marex-design/design_3v3_1v8_ltspice/design/pdf_schematic_ltspice.pdf

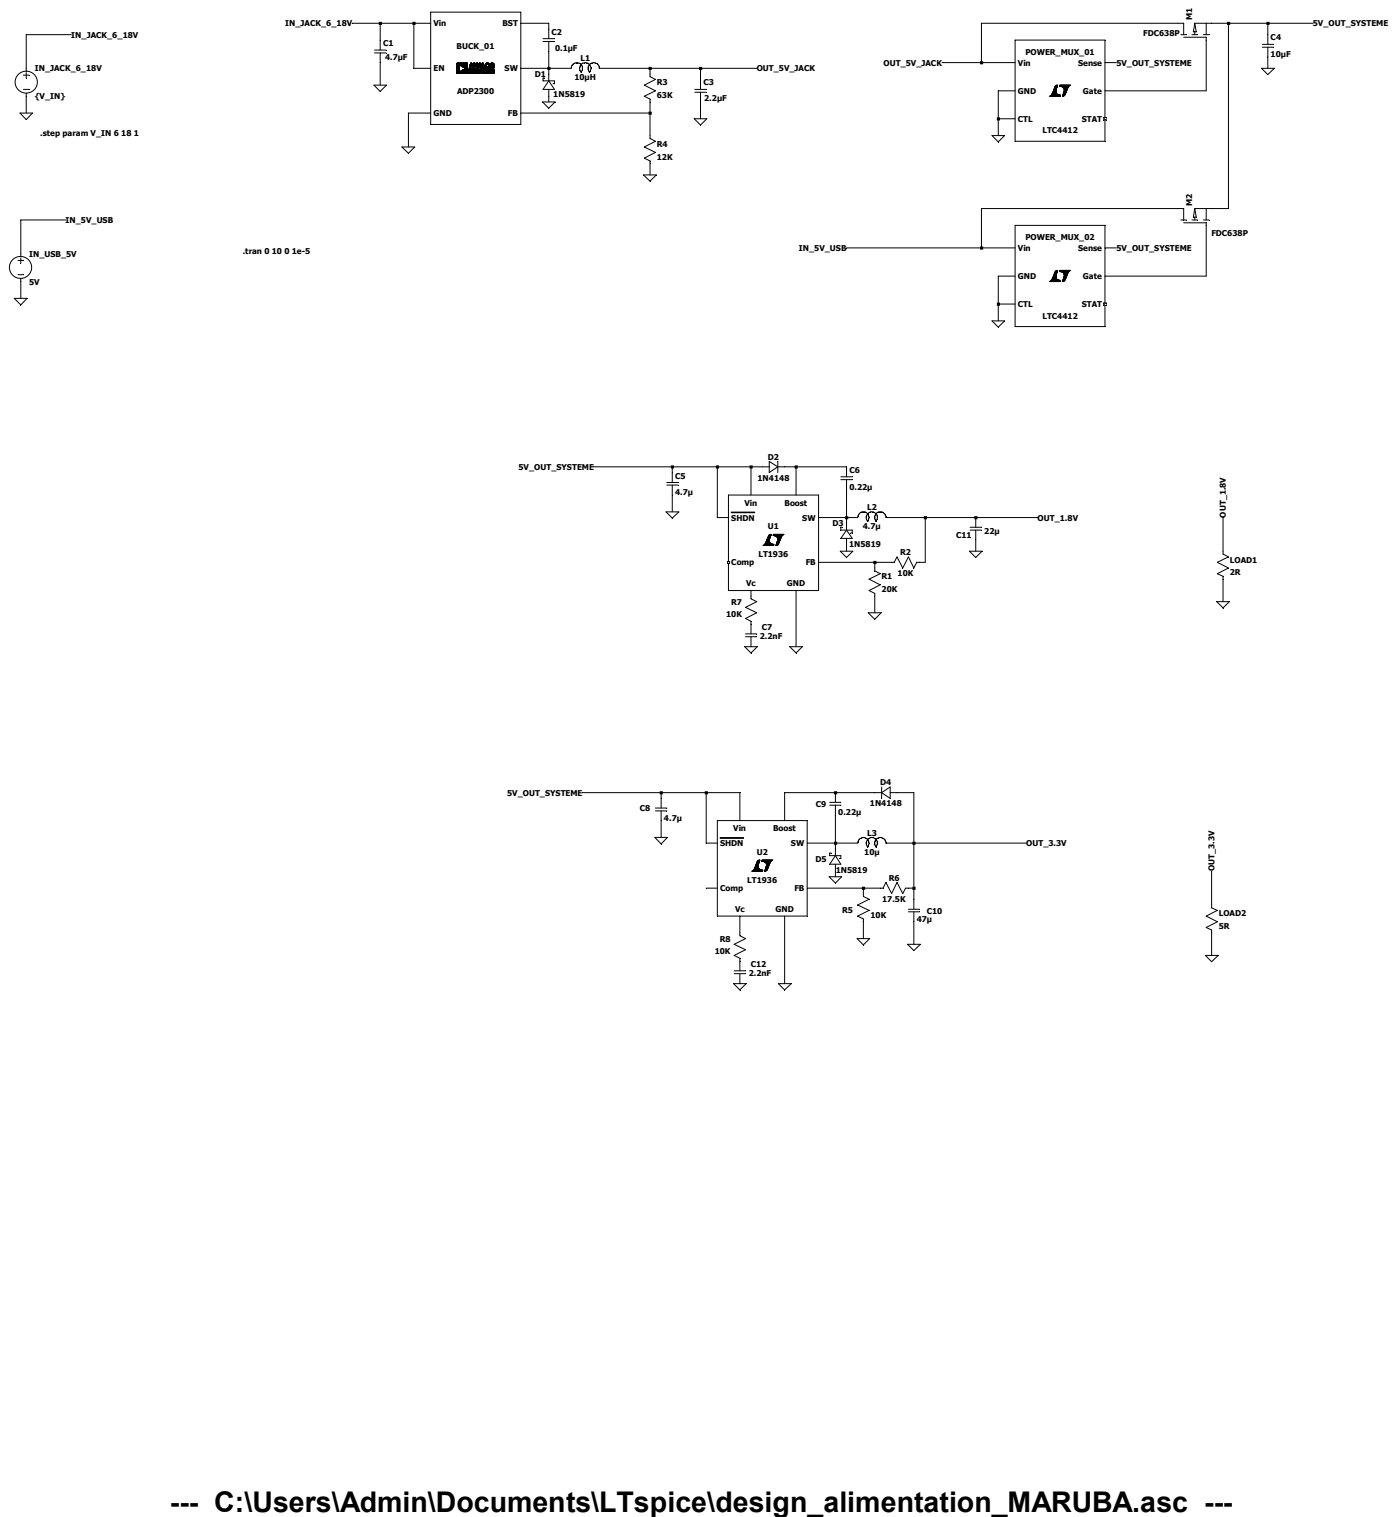
[picture p7: page 1]

--- C:\Users\Admin\Documents\LTspice\design_alimentation_MARUBA.asc ---
