marex-design/design_3v3_1v8_ltspice/design/design_alimentation_MARUBA.asc

BUCK_01: ADP2300
C1: cap; 4.7µF
C2: cap; 0.1µF
C3: cap; 2.2µF
C4: cap; 10µF
C5: cap; 4.7µ
C6: cap; 0.22µ
C7: cap; 2.2nF
C8: cap; 4.7µ
C9: cap; 0.22µ
C10: cap; 47µ
C11: cap; 22µ
C12: cap; 2.2nF
D1: schottky; 1N5819
D2: diode; 1N4148
D3: schottky; 1N5819
D4: diode; 1N4148
D5: schottky; 1N5819
IN_JACK_6_18V: voltage; {V_IN}
IN_USB_5V: voltage; 5V
L1: ind; 10µH
L2: ind; 4.7µ
L3: ind; 10µ
LOAD1: res; 2R
LOAD2: res; 5R
M1: pmos; FDC638P
M2: pmos; FDC638P
POWER_MUX_01: LTC4412
POWER_MUX_02: LTC4412
R1: res; 20K
R2: res; 10K
R3: res; 63K
R4: res; 12K
R5: res; 10K
R6: res; 17.5K
R7: res; 10K
R8: res; 10K
U1: LT1936
U2: LT1936
Named nets: 0, OUT_5V_JACK, 5V_OUT_SYSTEME, OUT_3.3V, IN_5V_USB, IN_JACK_6_18V, OUT_1.8V
.tran 0 10 0 1e-5
.step param V_IN 6 18 1
